jumbleview/Clock16/images/IMKP5093_acr.jpg

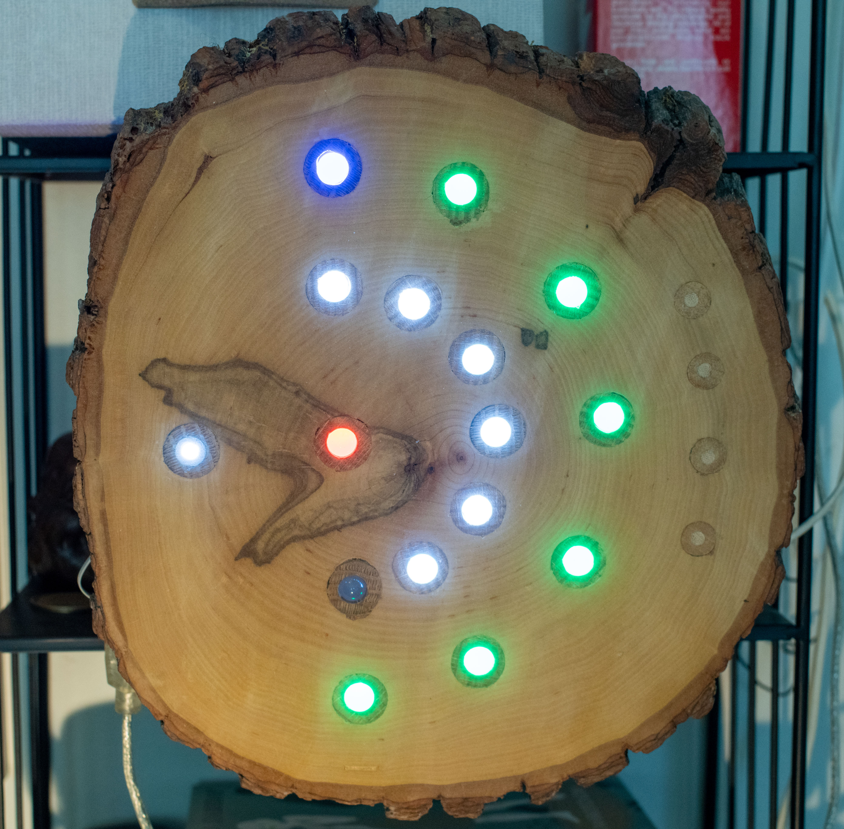
images/IMKP5093_acr.jpg
