jumbleview/Clock16/(list of files, drawings)

Other design files:
circuit/clock.dsn
